GiuseppeELio/Arduino_Interferometer_Stabilizer/GUI_working_example/GUI.png

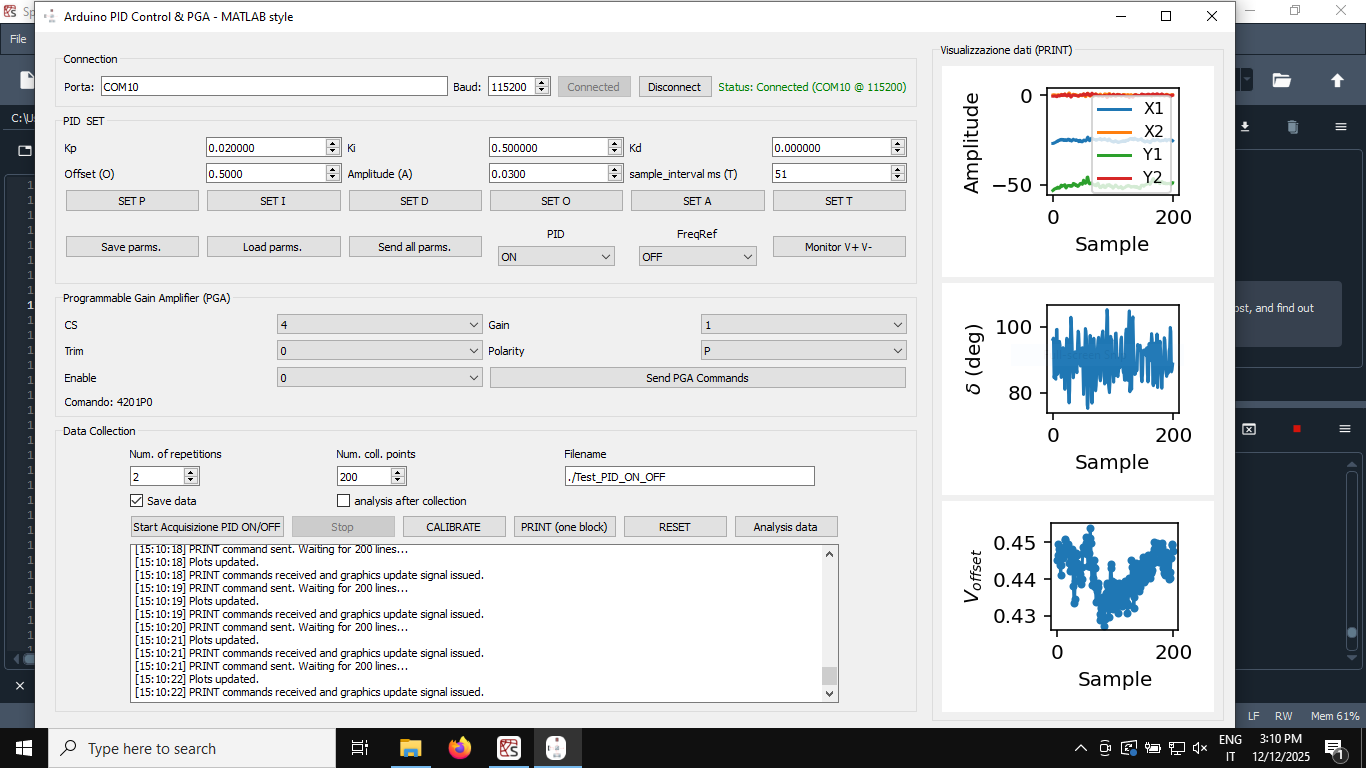
GUI_working_example/GUI.png
