GiuseppeELio/Arduino_Interferometer_Stabilizer/PCB_Gerber_BoM_PnP/BoM_Interferometer_Stabilizer (1).xlsx

No. | Quantity | Comment | Designator | Footprint | Value | Manufacturer Part | Manufacturer | Supplier Part | Supplier | JLCPCB Stock | LCSC Stock
1 | 1 | 33nF | C1 | C1206 | 33nF | GRM3195C1H333JA01D | muRata(村田) | C97930 | LCSC | 784
2 | 1 | 68nF | C2 | C1206 | 68nF | C3216C0G1H683JT000N | TDK | C361177 | LCSC | 280
3 | 3 | 100nF | C3,C16,C17 | C1206 | 100nF | GRM31C5C1H104JA01L | muRata(村田) | C97946 | LCSC | 131350
4 | 1 | 56nF | C4 | C1206 | 56nF | GRM31C5C1H563JA01L | muRata(村田) | C441752 | LCSC | 516
5 | 1 | 220nF | C5 | C1206 | 220nF | GRM31C5C1H224JE02L | muRata(村田) | C464977 | LCSC | 910
6 | 4 | 100nF | C6,C7,C8,C9 | C0805 | 100nF | CC0805KRX7R9BB104 | YAGEO(国巨) | C49678 | LCSC | 9266356
7 | 2 | 820nF | C10,C12 | C0805 | 820nF | 0805F824M500NT | FH(风华) | C67958 | LCSC | 1672
8 | 2 | 390nF | C11,C13 | C0603 | 390nF | TCC0603X7R394K500CT | CCTC(三环) | C376833 | LCSC | 161105
9 | 2 | 47nF | C14,C15 | C1206 | 47nF | GRM31M5C1H473JA01L | muRata(村田) | C21812 | LCSC | 25372
10 | 5 | BWSMA-KE-P001 | DETV+,DETV-,FREQREF,LIA_ext,PIEZO | SMA-SMD_BWSMA-KE-P001 |  | BWSMA-KE-P001 | BAT WIRELESS(蝙蝠无线) | C496550 | LCSC | 45266
11 | 4 | A-SP170UGC-A01-3T | LED1,LED3,LED5,LED7 | LED0805-RD_GREEN |  | A-SP170UGC-A01-3T | Amicc(欧密格光电) | C5179634 | LCSC | 4779
12 | 4 | D-R080508L3-KS2 | LED2,LED4,LED6,LED8 | LED0805-RD |  | D-R080508L3-KS2 | ARKLED(方舟) | C130114 | LCSC | 44291
13 | 1 | 15V SUPPLY | P1 | CONN-TH_3P-P5.00_WJ500V-5.08-3P |  | WJ500V-5.08-3P | KANGNEX(康奈克斯电气) | C72334 | LCSC | 13281
14 | 8 | 2.54mm 1*5P 直排针 | P2,P3,P4,P5,P6,P7,P8,P9 | HDR-TH_5P-P2.54-V-M |  | 2.54mm 1*5P 直排针 |  | C50951 | LCSC | 0
15 | 4 | 1.33kΩ | R1,R2,R3,R4 | R0603 | 1.33kΩ | RT0603BRD071K33L | YAGEO(国巨) | C861196 | LCSC | 4472
16 | 3 | 1.5kΩ | R5,R6,R7 | R0603 | 1.5kΩ | RT0603BRD071K5L | YAGEO(国巨) | C705741 | LCSC | 52672
17 | 1 | 1kΩ | R8 | R0603 | 1kΩ | RT0603BRD071KL | YAGEO(国巨) | C110776 | LCSC | 923819
18 | 1 | 3.2kΩ | R9 | R0603 | 3.2kΩ | RT0603BRD073K2L | YAGEO(国巨) | C861375 | LCSC | 832
19 | 9 | 10kΩ | R27,R28,R29,R30,R31,R32,R33,R34,R50 | R0805 | 10kΩ | 0805W8F1002T5E | UNI-ROYAL(厚声) | C17414 | LCSC | 29185006
20 | 2 | 10kΩ | R35,R37 | R0603 | 10kΩ | RT0603BRD0710KL | YAGEO(国巨) | C95204 | LCSC | 1229479
21 | 2 | 22kΩ | R36,R38 | R0603 | 22kΩ | ARG03FTC2202 | Viking(光颉) | C217885 | LCSC | 922
22 | 1 | 680Ω | R39 | R0805 | 680Ω | 0805W8F6800T5E | UNI-ROYAL(厚声) | C17798 | LCSC | 374016
23 | 1 | 330Ω | R40 | R0805 | 330Ω | 0805W8F3300T5E | UNI-ROYAL(厚声) | C17630 | LCSC | 1920512
24 | 1 | 3.6kΩ | R41 | R0603 | 3.6kΩ | ERA3AEB362V | PANASONIC(松下) | C473236 | LCSC | 0
25 | 1 | 270Ω | R42 | R0603 | 270Ω | RT0603BRD07270RL | YAGEO(国巨) | C861270 | LCSC | 5158
26 | 1 | 240Ω | R43 | R0603 | 240Ω | RT0603BRD07240RL | YAGEO(国巨) | C705750 | LCSC | 4283
27 | 3 | 5.1kΩ | R44,R48,R49 | R0603 | 5.1kΩ | RT0603BRD075K1L | YAGEO(国巨) | C122969 | LCSC | 2756
28 | 1 | 620Ω | R45 | R0603 | 620Ω | PTFR0603B620RP9 | RESI(开步睿思) | C351637 | LCSC | 657
29 | 1 | 430Ω | R46 | R0603 | 430Ω | TD03G4300BT | FH(风华) | C666878 | LCSC | 3343
30 | 1 | 9.1kΩ | R47 | R0603 | 9.1kΩ | RT0603DRD079K1L | YAGEO(国巨) | C706014 | LCSC | 1580
31 | 1 | 5.1kΩ | R51 | R0805 | 5.1kΩ | 0805W8F1002T5E | UNI-ROYAL(厚声) | C844854 | LCSC | 5612
32 | 2 | LM324DT | U1,U8 | SOIC-14_L8.7-W3.9-P1.27-LS6.0-BL |  | LM324DT | ST(意法半导体) | C71035 | LCSC | 118277
33 | 1 | 2.67kΩ | U2 | R0603 | 2.67kΩ | AR03BTCX2671A | Viking(光颉) | C2924131 | LCSC | 13
34 | 4 | MAX9939AUB+ | U3,U4,U5,U6 | MSOP-10_L3.0-W3.0-P0.50-LS5.0-BL |  | MAX9939AUB+ | ADI(亚德诺)/MAXIM(美信) | C143637 | LCSC | 0
35 | 1 | TLV9301IDBVR | U7 | SOT-23-5_L3.0-W1.7-P0.95-LS2.8-BR |  | TLV9301IDBVR | TI(德州仪器) | C2867945 | LCSC | 2824
36 | 1 | 8.2kΩ | U9 | R0603 | 8.2kΩ | RT0603BRD078K2L | YAGEO(国巨) | C861589 | LCSC | 6477
