GiuseppeELio/Arduino_Interferometer_Stabilizer/Schematics/Schematics_Interferometer_Stabilizer.pdf

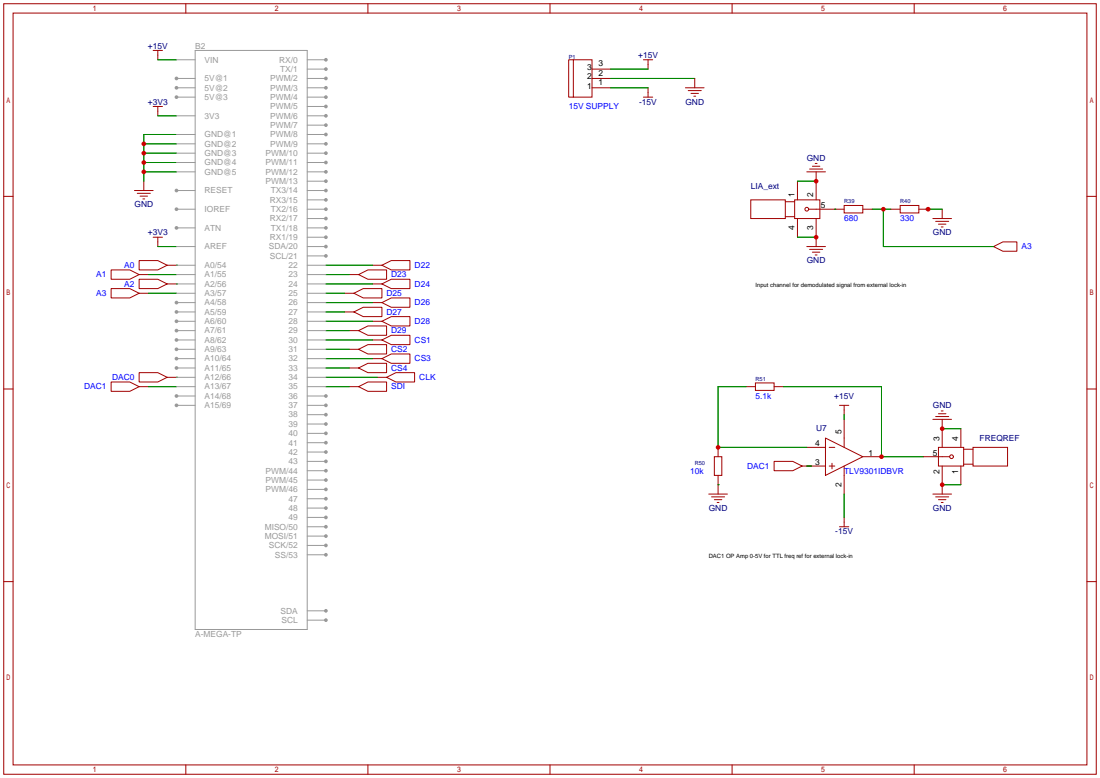
[picture p5: page 1]

Input channel for demodulated signal from external lock-in

DAC1 OP Amp 0-5V for TTL freq ref for external lock-in

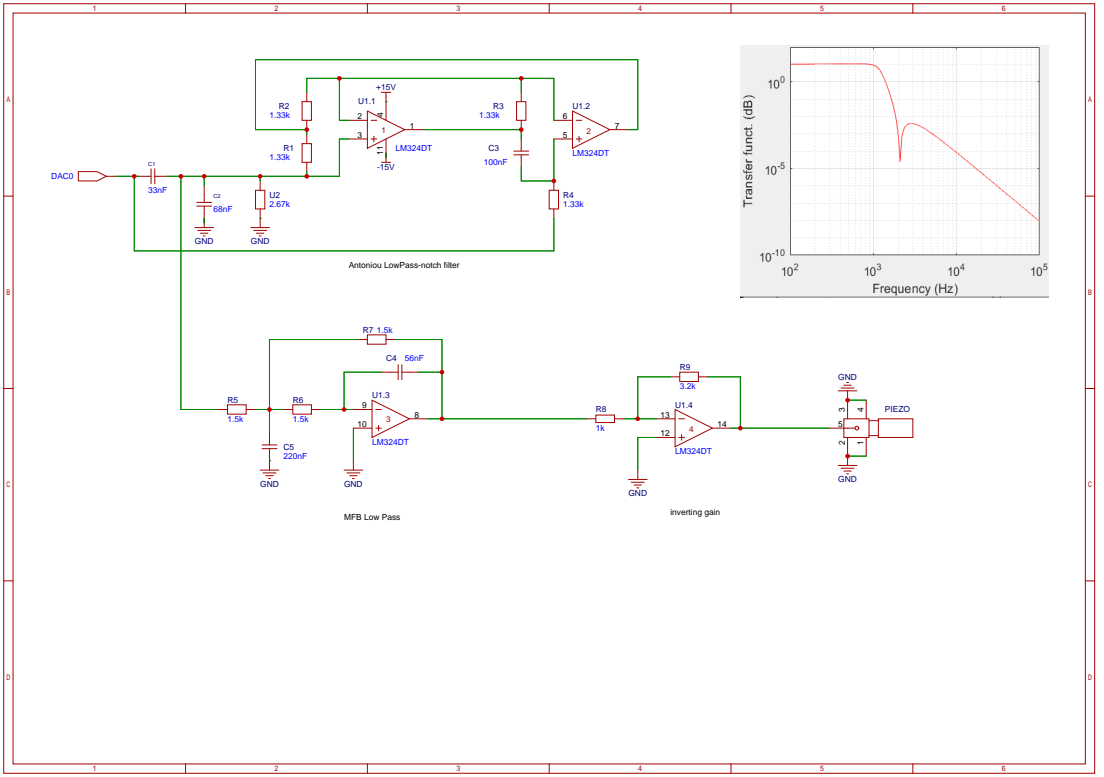
[picture p6: page 2]

Antoniou LowPass-notch filter

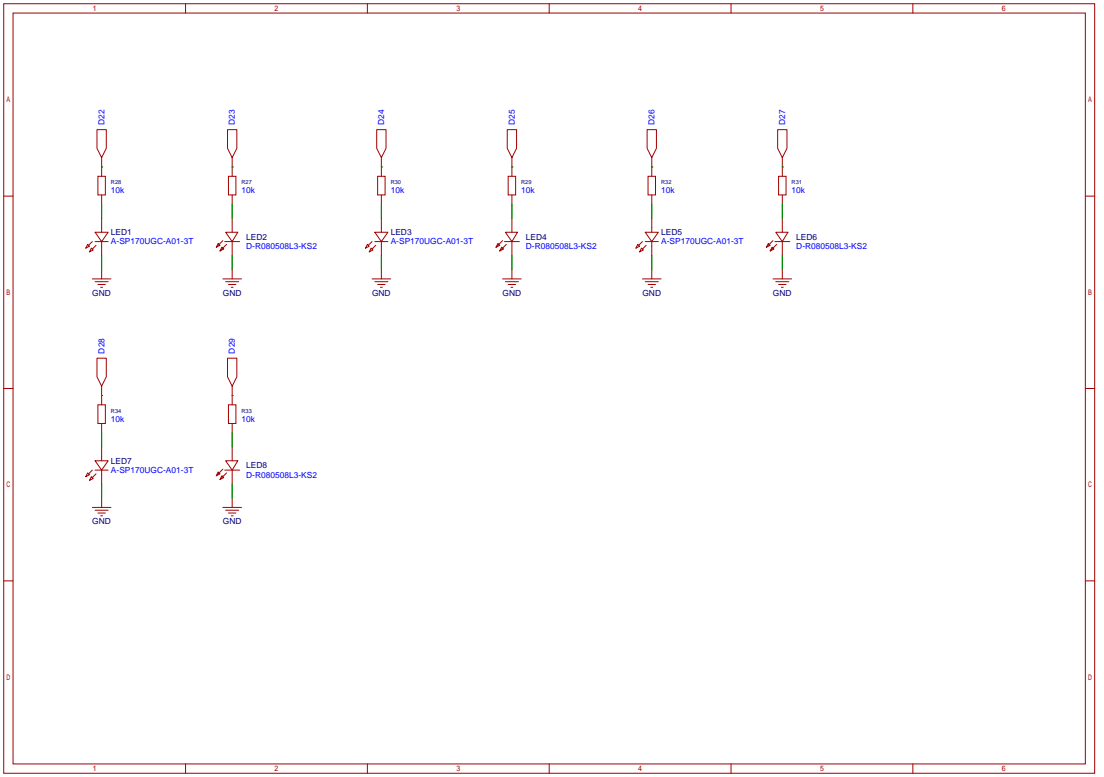
[picture p7: page 3]

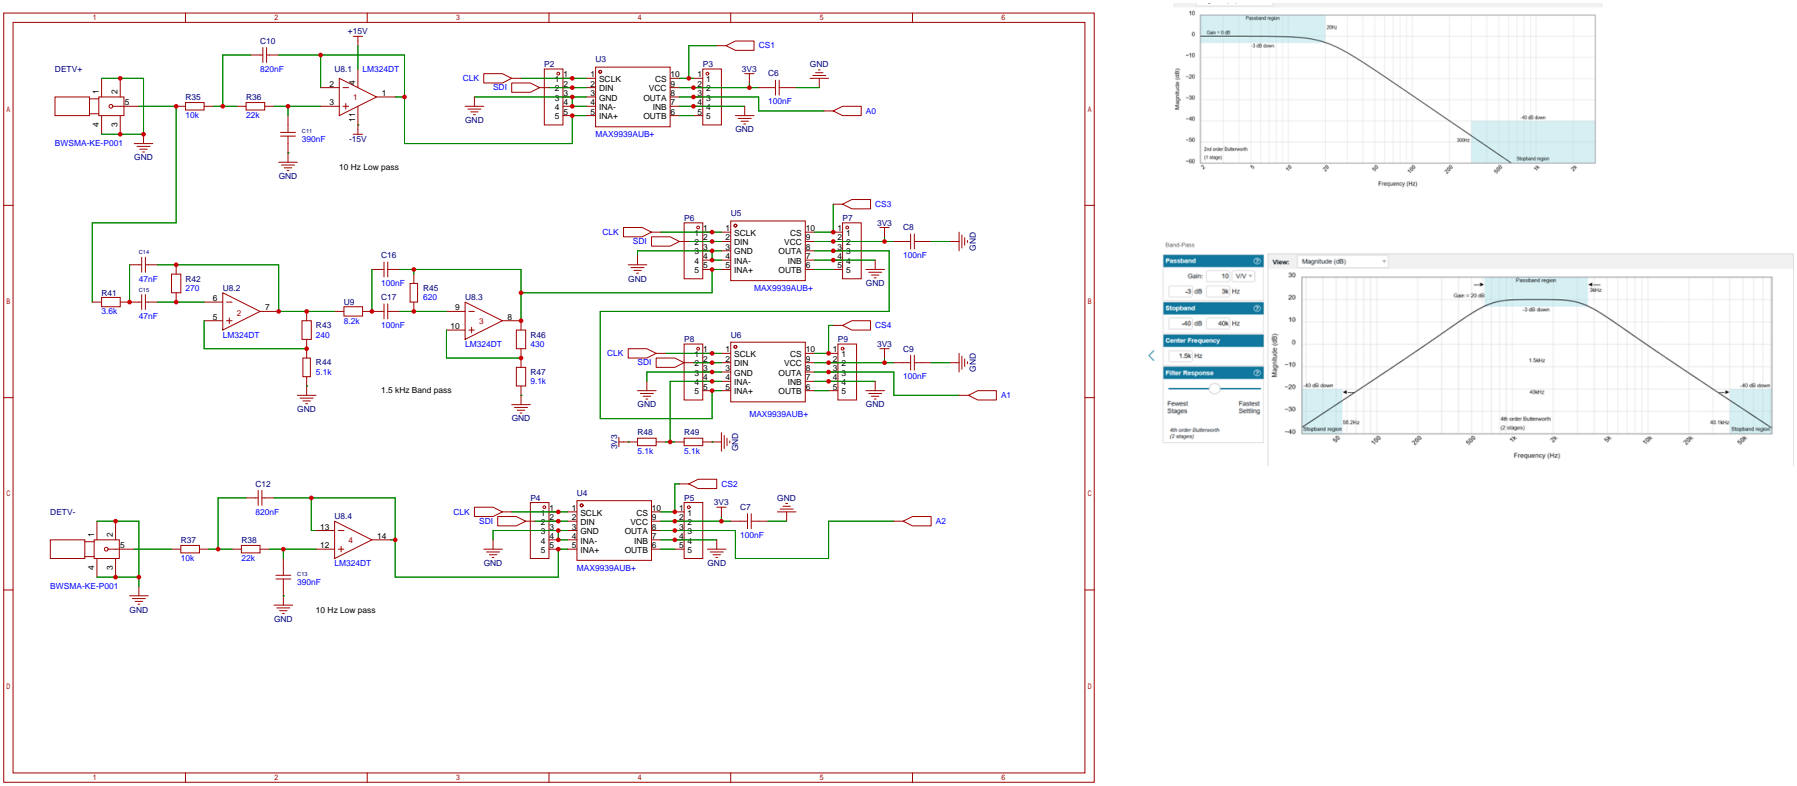
[picture p8: page 4]
