GiuseppeELio/Arduino_Interferometer_Stabilizer/(commit log)

2025-12-15 Python GUI code updated
    [pid_config.json]
2025-12-15 Code used for multiple assessment tests
    We used this script to asses the lock-in characteristics time (tau), and the other working parameters for the PID
2025-12-15 Schematics and PCB manufacturing documents
    [BoM_Interferometer_Stabilizer (1).xlsx, PickAndPlace_Interferometer_Stabilizers.xlsx]
2026-04-09 Updated GUI
    This GUI has been updated to show correctly the values with a proper aspect ratio and plot legend size.
    [InterferometerStabilizer_GUI_Py.py]
2026-05-08 Update Interferometer firmware
    8th May 2026
    The firmware have been updated and commented. Now it shows all the variables initialized at the begin, the void setup and void loop and the other functions used in this project.
    [Firmware.ino]
2026-05-22 A new Web Application
    This is a web application to manage the Arduino Interferometer directly by web or just using the html file locally
    [pid_config.json]
2026-05-22 Update README with web application details
    Added information about the new web application for the Arduino Interferometer Stabilizer, including usage instructions.
